arp2019-Dev/ARPIGlasses/colorsim.png

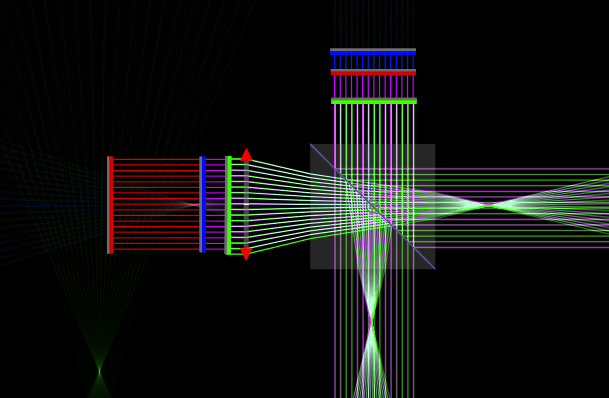
colorsim.png
