arp2019-Dev/ARPIGlasses/Main Board/PCB3.png

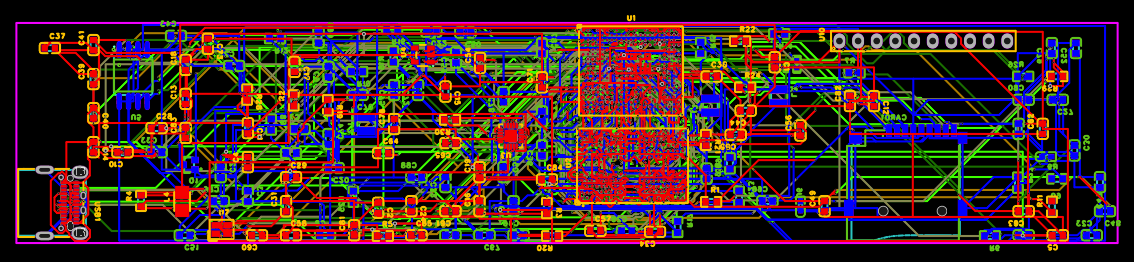
Main Board/PCB3.png
