arp2019-Dev/ARPIGlasses/CAD/cad1.png

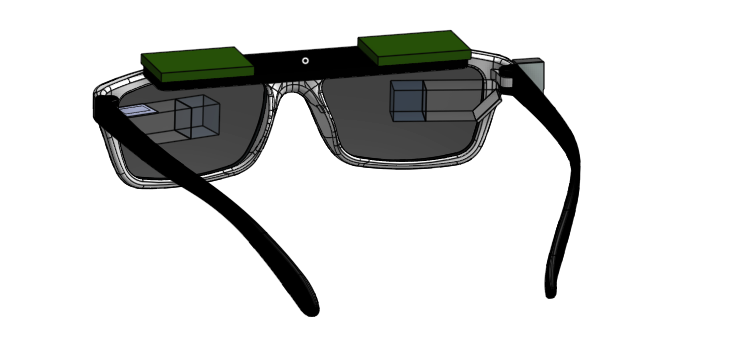
CAD/cad1.png
