arp2019-Dev/ARPIGlasses/CAD/cad2.png

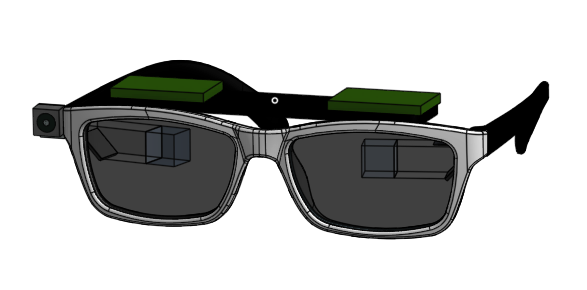
CAD/cad2.png
