arp2019-Dev/ARPIGlasses/Main Board/PCB1.png

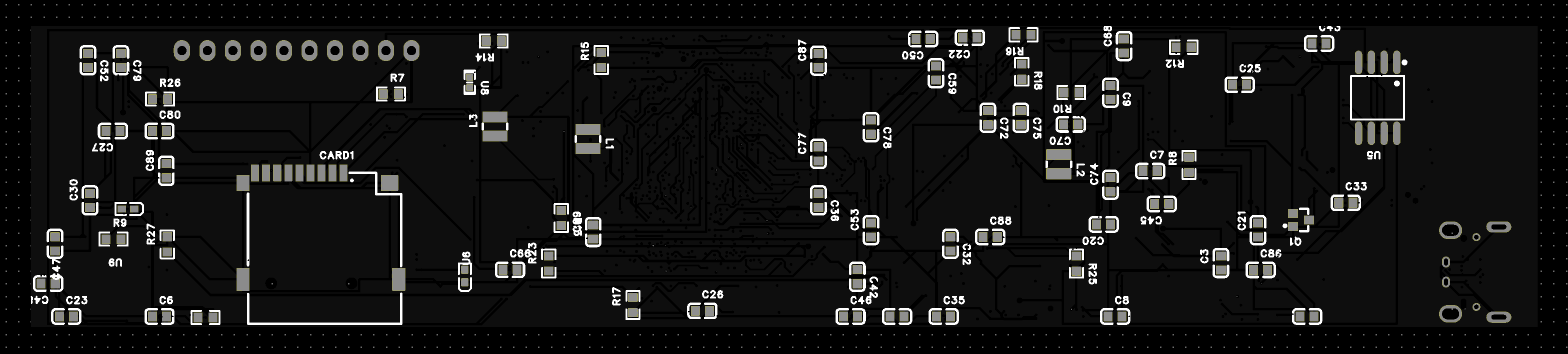
Main Board/PCB1.png
