arp2019-Dev/ARPIGlasses/Main Board/PCB2.png

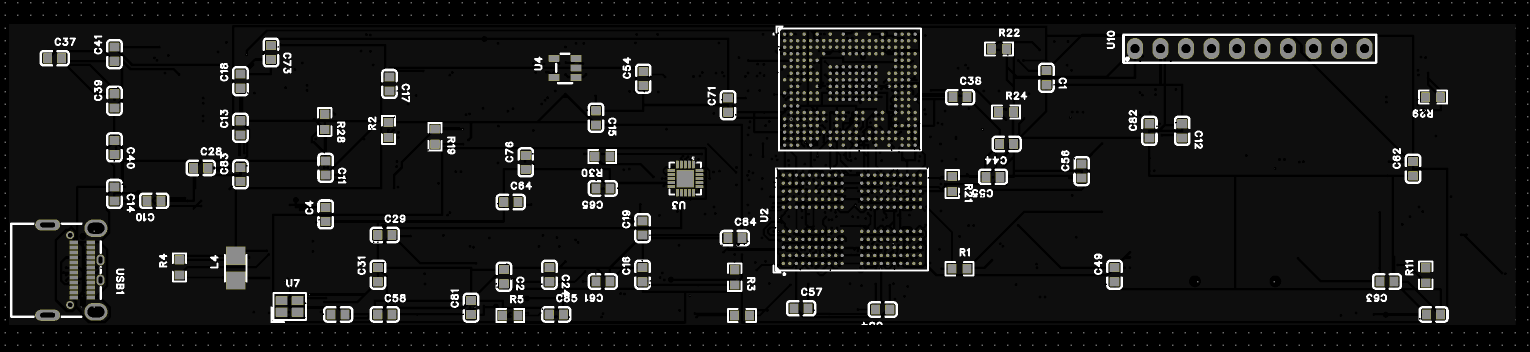
Main Board/PCB2.png
