arp2019-Dev/ARPIGlasses/Main Board/PCB4.png

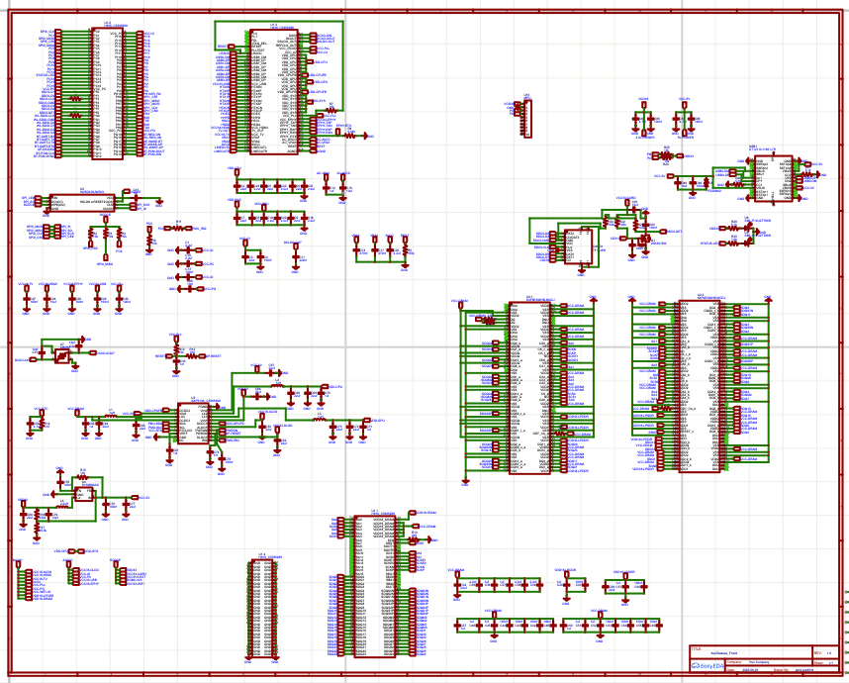
Main Board/PCB4.png
