arp2019-Dev/ARPIGlasses/ARPIGlasses BOM - Sheet1.csv

Part | QTY | Total Price | Link
Semi Transperent Mirror | 2 | 12.44 | https://www.aliexpress.com/item/3256806701424972.html?mp=1
7v to 5v Buck Converter | 1 | 2.29 | https://www.aliexpress.com/item/3256808454422494.html?mp=1
2S lipo charger module | 1 | 4.19 | https://www.aliexpress.com/item/3256808548137652.html?mp=1
LPDDR4 BGA Stencil | 1 | 4.66 | https://www.aliexpress.com/item/3256804491507637.html?mp=1
Orange Pi Zero 2 W | 1 | 24 | https://www.aliexpress.com/item/3256805793020466.html?mp=1
LPDDR4 BGA Chip (4GB) | 1 | 4 | https://www.aliexpress.com/item/3256808641238278.html?mp=1
LOCA (Optical Clear Glue) | 1 | 9 | https://www.aliexpress.com/item/2255800983414695.html?mp=1
3.7v 300mah LIPO | 2 | 7 | https://www.aliexpress.com/item/3256808480833790.html?mp=1
Polarizing Beam Splitter Cube | 2 | 24 | https://www.aliexpress.com/item/3256801646317160.html?mp=1
MPU 9250 | 1 | 5 | https://www.aliexpress.com/item/3256805884551296.html?mp=1
OV5640 AF Camera module | 1 | 15 | https://www.aliexpress.com/item/3256806547258124.html?mp=1
USBC Data Cable | 1 | 1.39 | https://www.aliexpress.com/item/3256808160909171.html?mp=1
0.2" FLCOS Display | 2 | 102.3 | https://www.aliexpress.com/item/3256808372893146.html?mp=1
Soldering Misc. (Paste, etc.) | 1 | 40.23
Shipping | 1 | 35.41
PCB + Stencil | 1 | 60
 |  | TOTAL COST:
 |  | 350.91
