arp2019-Dev/ARPIGlasses/Main Board/BOM_ArpGlass_PCB_ArpGlass_2025-06-13.xlsx

No. | Quantity | Comment | Designator | Footprint | Value | Manufacturer Part | Manufacturer | Supplier Part | Supplier
1 | 9 | 2.2uf | C1,C16,C18,C19,C20,C21,C22,C23,C25 | C0603
2 | 19 | 100nf | C2,C13,C27,C28,C29,C30,C41,C42,C43,C44,C48,C49,C53,C54,C55,C56,C75,C76,C78 | C0603
3 | 21 | 22uf | C3,C4,C5,C6,C7,C8,C9,C34,C58,C60,C62,C63,C64,C66,C67,C68,C69,C72,C73,C77,C80 | C0603
4 | 3 | 10uf | C10,C24,C26 | C0603
5 | 1 | 220nf | C11 | C0603
6 | 16 | 1uf | C12,C15,C36,C37,C40,C45,C46,C47,C50,C51,C52,C57,C61,C65,C70,C71 | C0603
7 | 2 | 470nf | C14,C17 | C0603
8 | 3 | 12pf | C31,C32,C79 | C0603
9 | 2 | 1nf | C33,C74 | C0603
10 | 3 | 2.2nf | C35,C38,C39 | C0603
11 | 1 | 4.7uf | C59 | C0603
12 | 1 | TF PUSH | CARD1 | TF-SMD_TF-PUSH |  | TF PUSH | SHOU HAN(首韩) | C393941 | LCSC
13 | 3 | 1uH | L1,L2,L3 | IND-SMD_L2.5-W2.0_AHP252010X |  | SWPA252012S1R0MT | Sunlord(顺络) | C66001 | LCSC
14 | 1 | 2.2uH | L4 | IND-SMD_L2.5-W2.0_WPN252012H |  | WPN252012H2R2MT | Sunlord(顺络) | C98350 | LCSC
15 | 2 | 10 | R1,R9 | R0603
16 | 6 | 10k | R2,R3,R4,R6,R10,R15 | R0603
17 | 1 | 150k | R5 | R0603
18 | 1 | 20k | R7 | R0603
19 | 1 | 6.04k | R8 | R0603
20 | 1 | 0 | R11 | R0603
21 | 1 | 100 | R12 | R0603
22 | 3 | 240 | R13,R18,R19 | R0603
23 | 1 | 510 | R14 | R0603
24 | 1 | 232k | R16 | R0603
25 | 1 | 49.9k | R17 | R0603
26 | 2 | 100k | R20,R21 | R0603
27 | 1 | IPEX-4 | RF1 | IPEX-SMD_4P-L1.8-W1.7-LS2.0 |  | IPEX-4 | Ziisor(致哲) | C2987683 | LCSC
28 | 1 | H616_C5365289 | U1 | BGA-284_L14.0-W12.0-P0.65-TL |  | H616 | Allwinner(全志) | C5365289 | LCSC
29 | 1 | K4F8E304HB-MGCJ | U2 | BGA-200_L15.0-W10.0_K4F8E304HB-MGCJ |  | K4F8E304HB-MGCJ | SAMSUNG(三星半导体) | C2803257 | LCSC
30 | 1 | AXP313A_C5365290 | U3 | QFN-20_L3.0-W3.0-P0.40-BL-EP1.7 |  | AXP313A | x-powers | C5365290 | LCSC
31 | 1 | SY8089AAC | U4 | SOT-23-5_L2.9-W1.6-P0.95-LS2.8-BL |  | SY8089AAC | null | C5187495 | LCSC
32 | 1 | W25Q128JWSIQ | U5 | SOIC-8_L5.3-W5.3-P1.27-LS8.0-BL |  | W25Q128JWSIQ | WINBOND(华邦) | C2763561 | LCSC
33 | 1 | device_cd4e | U6 | COMM-SMD-44_L12.0-W12.0-P0.90-TL_BL-R8189FTV
34 | 1 | 24MHz | U7 | CRYSTAL-SMD_4P-L2.0-W1.6-BL-2 |  | 2016 24M 12PF 10PPM | SST(索斯特) | C5181486 | LCSC
35 | 1 | UT12113-11601-7H | USB1 | USB-C-SMD_UT12113-11601-7H |  | UT12113-11601-7H | FOXCONN(富士康) | C2761409 | LCSC
