arp2019-Dev/ARPIGlasses/Main Board/SCH_ArpiGlasses_2025-06-16.pdf

PG12 C9 PG11 B10 PG10 C8 PG9 B3 PG8 C4 PG7 B4 PG6 A4 PG5 B7 PG4 C5 PG3 B5 PG2 C6 PG1 C7 PG0 A6 PF6 K2 PF5 L3 PF4 L2 PF3 K3 PF2 K1 PF1 J3 PF0 J2 VCC_PC F5 PC16 H3 PC15 H2 PC14 H1 PC13 G3 PC12 G2 PC11 F3 PC10 F2 PC9 F1 PC8 E3 PC7 F4 PC6 E2 PC5 D3 PC4 D2 PC3 D1 PC2 C1 PC1 C2 PC0 B1
AGND H18 LINEOUTR G20 LINEOUTL G19 AVCC H17 VRA2 J17 VRA1 J18 VCC_TV H20 TV_OUT J21 VCC_HDMI F18 HSDA G21 HSCL F19 HHPD G18 HCEC G17 HTXCP F20 HTXCN F21 HTX2P C19 HTX2N C20 HTX1P D20 HTX1N D21 HTX0P E19 HTX0N E20 VCC_USB M18 USB3_DP L20 USB3_DM L19 USB2_DP K20 USB2_DM K19 USB1_DP M20 USB1_DM M19 USB0_DP J20 USB0_DM J19 LRADC L18 PLLTEST D14 RESET A16 JTAG_SEL C16 FEL B17 PL1 B18 PL0 C18

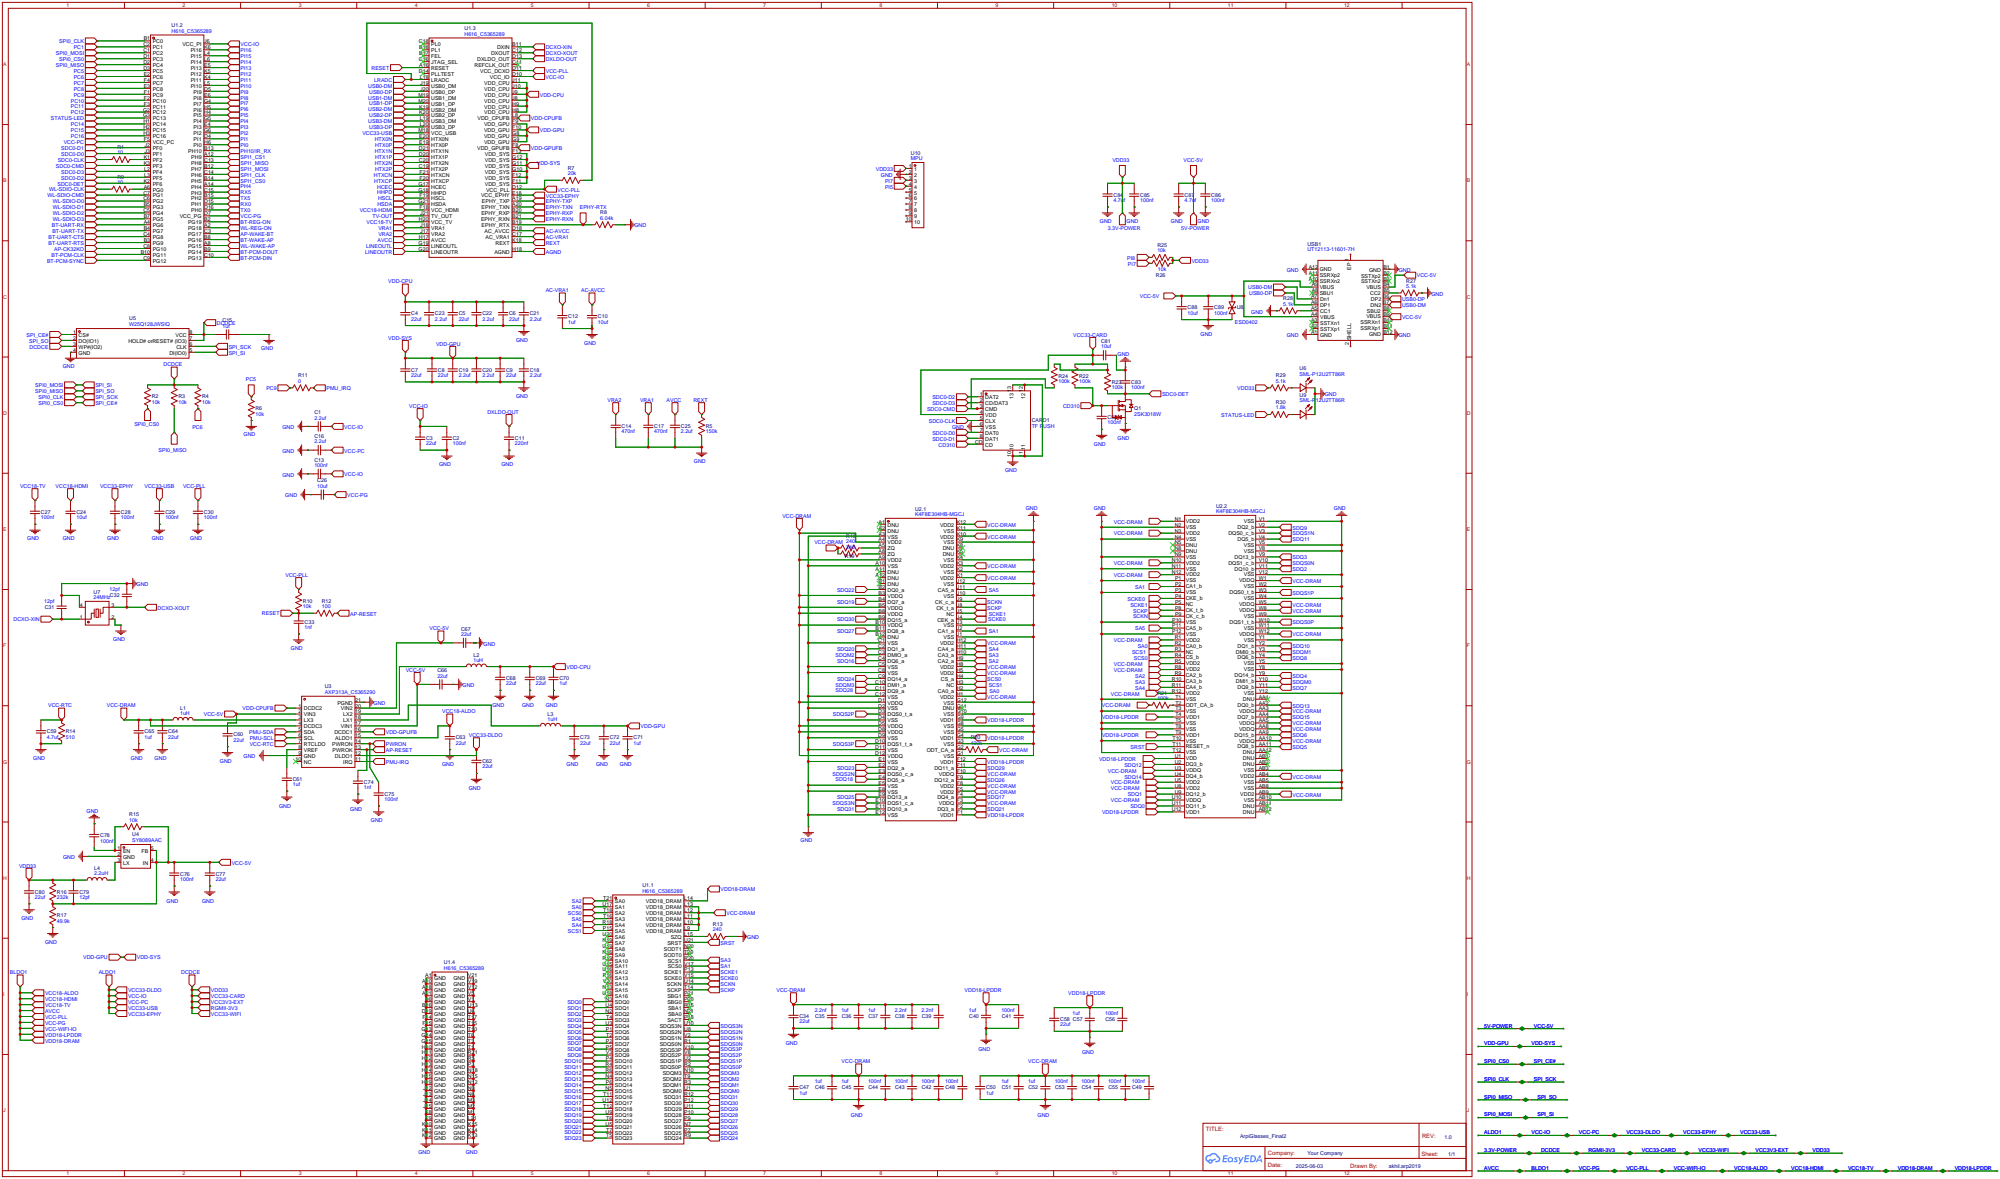
[picture p8: page 1]

SCS0
SCS1
GND K13 GND K12 GND K11 GND K10 GND K9 GND K8 GND J15 GND J14 GND J13 GND J12 GND H19 GND H15 GND H14 GND H13 GND H12 GND H11 GND H10 GND G15 GND G14 GND G13 GND F15 GND F14 GND D19 GND B16 GND B6 GND A21 GND A18 GND A10 GND A1
