arp2019-Dev/ARPIGlasses/(list of files, drawings)

Other design files:
Main Board/ProPrj_ArpiGlasses_Final2_2025-06-16.epro
